ozitronics/LoRa1284/Docs/LoRa1284v1.1 pinout.png

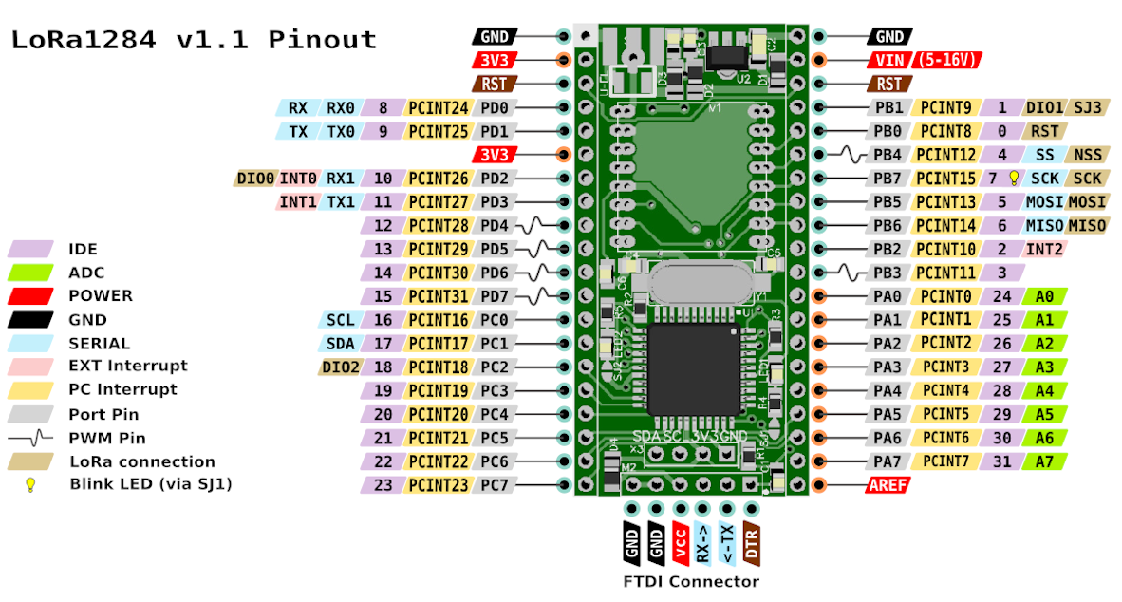
Docs/LoRa1284v1.1 pinout.png
