ozitronics/LoRa1284/Docs/LoRa1284 photo.jpg

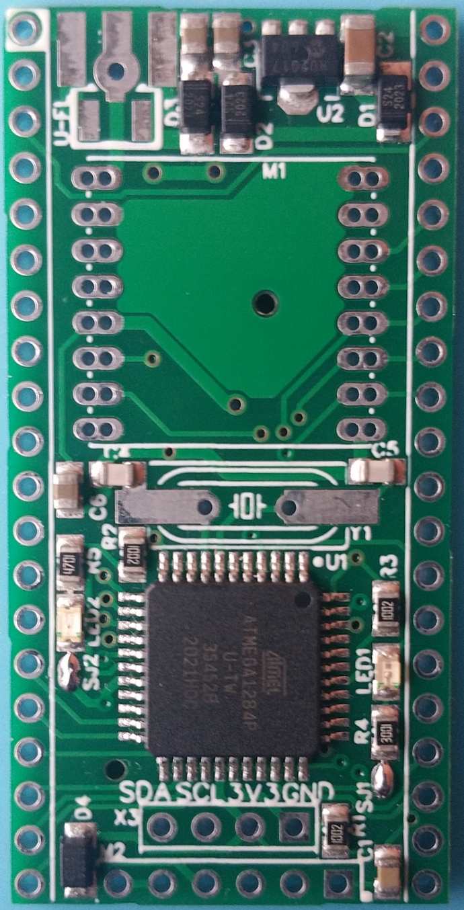
Docs/LoRa1284 photo.jpg
