ozitronics/LoRa1284/Docs/LoRa1284_1.1 schematic.pdf

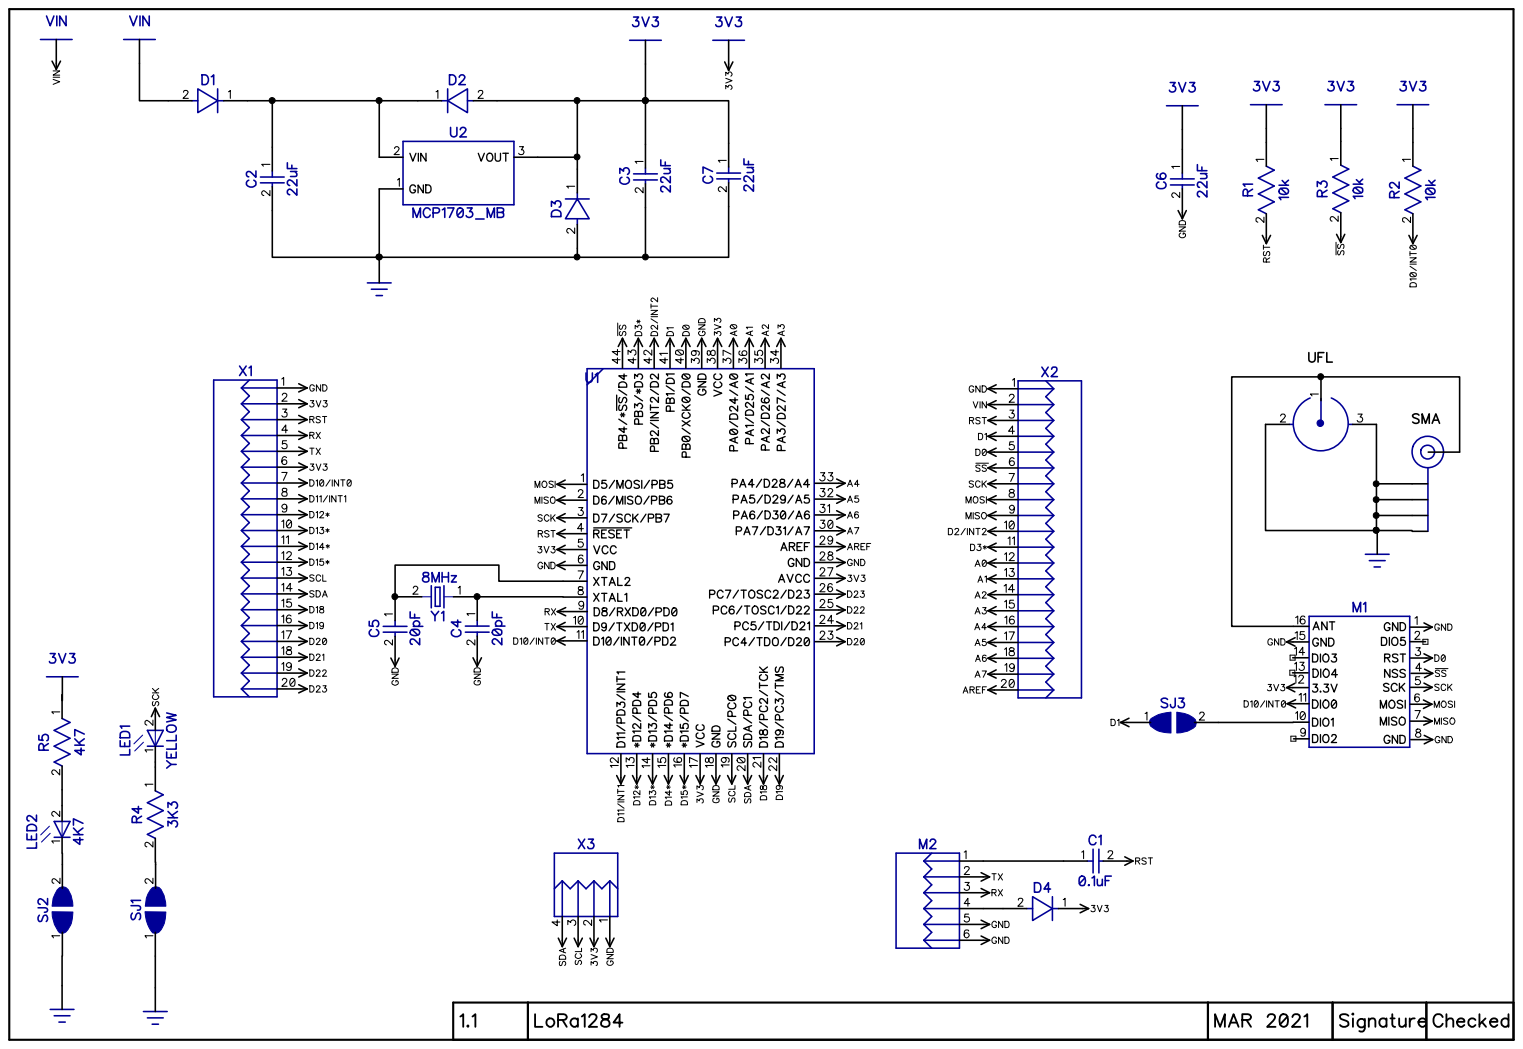
[picture p3: page 1]
